andrewgho/loragate/mount/mount.3mf

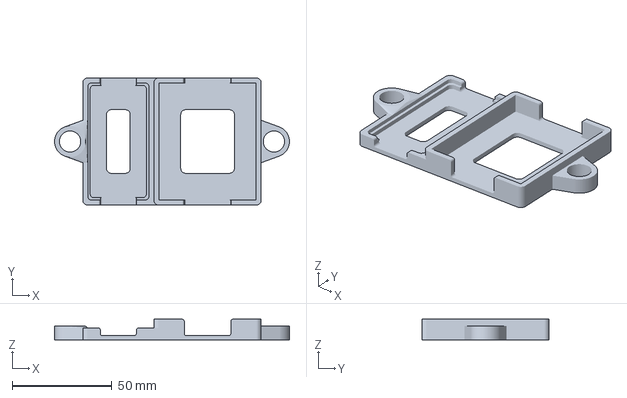
[picture p1: CAD file, 2026-10-29]
mount/mount.3mf
117.6 x 63.7 x 10.3 mm
