andrewgho/loragate/(list of files, cad)

Other CAD files:
mount/mount.stl
