andrewgho/loragate/kicad/loragate_tht/loragate_tht.kicad_pcb

## KiCad design kicad/loragate_tht/loragate_tht.kicad_pcb (2026-10-20)

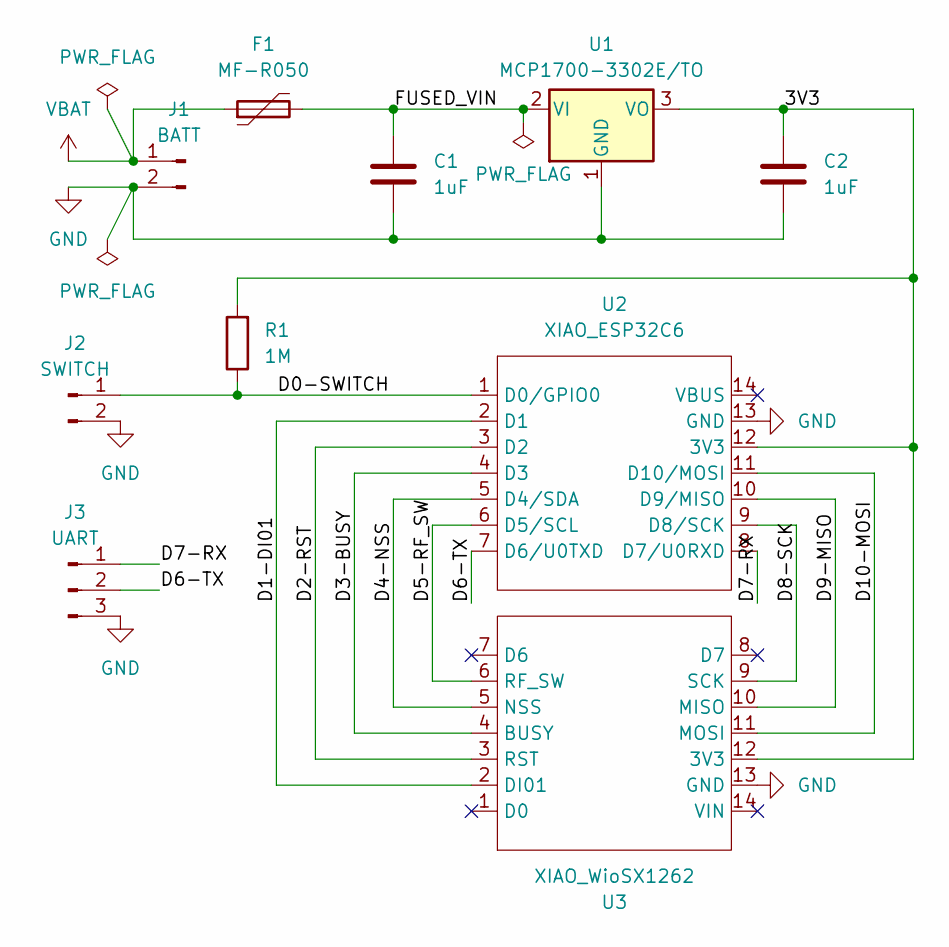
[picture p6: schematic loragate_tht.kicad_sch]

Parts:
C1, C2: 1uF; C_Disc_D5.0mm_W2.5mm_P5.00mm
F1: MF-R050; C_Disc_D8.0mm_W2.5mm_P5.00mm
J1: BATT; Molex_KK-254_AE-6410-02A_1x02_P2.54mm_Vertical
J2: SWITCH; PinHeader_1x02_P2.54mm_Vertical
J3: UART; PinHeader_1x03_P2.54mm_Vertical
R1: 1M; R_Axial_DIN0207_L6.3mm_D2.5mm_P10.16mm_Horizontal
U1: MCP1700-3302E/TO; TO-92_Inline_Wide
U2: XIAO_ESP32C6; XIAO_Module_Socket_2x7_P2.54mm_W15.24mm
U3: XIAO_WioSX1262; XIAO_Module_Pin_Flipped_2x7_P2.54mm_W15.24mm

Connections:
/3V3: C2.1, R1.2, U1.3 (VO), U2.12 (3V3), U3.12 (3V3)
/D0-SWITCH: J2.1, R1.1, U2.1 (D0/GPIO0)
/D1-DI01: U2.2 (D1), U3.2 (DI01)
/D2-RST: U2.3 (D2), U3.3 (RST)
/D3-BUSY: U2.4 (D3), U3.4 (BUSY)
/D4-NSS: U2.5 (D4/SDA), U3.5 (NSS)
/D5-RF_SW: U2.6 (D5/SCL), U3.6 (RF_SW)
/D6-TX: J3.2, U2.7 (D6/U0TXD)
/D7-RX: J3.1, U2.8 (D7/U0RXD)
/D8-SCK: U2.9 (D8/SCK), U3.9 (SCK)
/D9-MISO: U2.10 (D9/MISO), U3.10 (MISO)
/D10-MOSI: U2.11 (D10/MOSI), U3.11 (MOSI)
/FUSED_VIN: C1.1, F1.2, U1.2 (VI)
GND: C1.2, C2.2, J1.2, J2.2, J3.3, U1.1 (GND), U2.13 (GND), U3.13 (GND)
VBAT: F1.1, J1.1

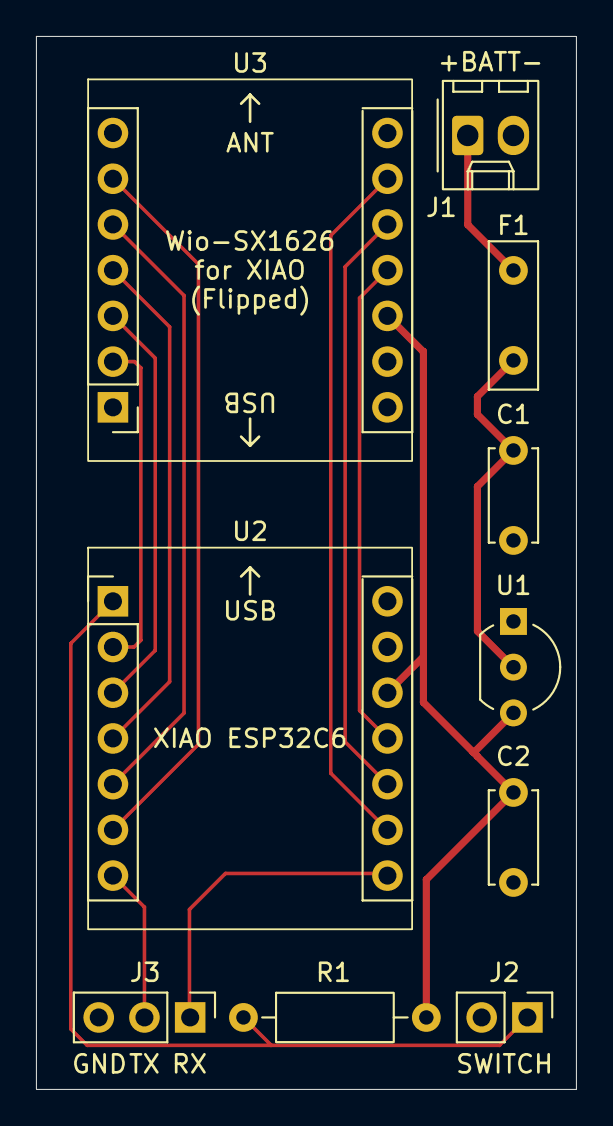
[picture p7: board loragate_tht.kicad_pcb from above]

Board: 2 copper layers, 30.0 x 58.5 mm, 10 parts (0 on the bottom side), 15 nets.
