andrewgho/loragate/(commit log)

2026-08-13 Fix pinout based on inspecting PCB manually
    [lora_pins.h]
2026-08-13 Enable DIO2 as RF switch control
    Packets weren't reaching the receiver even with pins confirmed
    correct; the SX1262 doesn't route DIO2 to the antenna switch by
    default; without radio.setDio2AsRfSwitch(true), transmit()/
    startReceive() report success but the switch never moves.
    Claude-Session: https://claude.ai/code/session_01Q1pFKiFBHSL76JCQTtfQUk
    [lora_pins.h]
2026-08-17 Add txno to packet, wire RSSI/SNR/txno into the report URL, ack-drop test knob
    txno records which transmit attempt got through (0 = first try), letting
    the server distinguish a retried link from a clean one — RSSI/SNR alone
    only describe the packet that succeeded, not whether earlier attempts on
    either leg (data out or ack back) were lost. ACK_DROP_PCT on rx-test lets
    tx-test's retry/backoff be exercised without real radio interference.
    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
    [lora_packet.h]
2026-08-27 Add transmitter build plan and wiring docs
    Physical build reference for the phase-2 transmitter (reed switch, battery,
    optional RTC), adapted from an AI-authored first draft. Corrects two things
    that draft got wrong against our actual hardware: the reed switch pin
    (D4 collides with the confirmed LoRa NSS pin) and the direct battery-to-3V3
    power architecture (3V3 is unprotected VDD; a fresh 2-cell lithium pack has
    near-zero margin against the chip's own voltage ceiling). Settled on a
    TPS7A0233 nanopower LDO + third cell, built from a bare SOT23-5 chip on a
    generic adapter board since no ready-made breakout exists at this
    quiescent-current tier.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
2026-08-27 Confirm PA0086C SOT23-5-to-DIP-6 adapter for the TPS7A02 LDO
    Checked the datasheet directly: 0.100" pin pitch, 0.300" row spacing
    (standard DIP-6/breadboard grid) and factory-installed DIP pins, so it
    drops straight into any 0.1"-grid protoboard with nothing left to solder
    but the bare LDO chip's 5 leads. DigiKey link is the preferred purchase
    source.
    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
2026-08-27 Lock in Perma-Proto Quarter and TPS7A0233PDBVR purchase links
    Settles two open build choices with DigiKey links: Adafruit Perma-Proto
    Quarter-sized board (breadboard-style bus strips, room for the LDO/adapter/
    resistor/JST-PH alongside the stack's socket without needing a second
    board) and TPS7A0233PDBVR for the LDO. Noted that the P-suffix variant is
    just a different assembly/test site per TI's own part-numbering convention,
    not a spec or pinout difference from TPS7A0233DBVR.
    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
2026-08-27 Add Keystone 2465 battery holder to the BOM
    Confirmed series wiring (4.5V, not parallel) and bare 6" leads before
    adding, since it's used directly with the JST-PH splice already planned in
    the Power section.
    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
2026-08-27 Confirm antenna chain parts, switch bypass caps to through-hole, track ownership
    Antenna chain needs two parts, not one: RF Solutions CBA-UFLSMA-1 (U.FL to
    SMA bulkhead pigtail, confirmed standard SMA not RP-SMA) and Nearson
    S463AM-915 (matching standard SMA male whip, 915MHz) - confirmed connector
    types match so the antenna actually threads onto the bulkhead. Antenna has
    no stated weatherproof rating, flagged as an open tradeoff against sourcing
    everything from one vendor.
    Capacitors switched from SMD to through-hole per no other SMD tooling in
    the build. BOM now tracks what's already on hand vs. still needed.
    Claude-Session: https:/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
2026-09-09 Add phase-2 tx/rx sketches, build/test tooling, and protocol tests
    New tx/ and rx/ sketches implement the door-sensor protocol sketched in
    README.md's "Planned protocol": heartbeat on a fixed cadence plus
    door-open/door-close events, all sharing one seq counter through the same
    send/ack/retry link layer as tx-test/rx-test. Deep sleep is left out for now
    so both ends can be watched live over serial. The reed-switch handling
    debounces the pin and, after each send/retry cycle finishes, rechecks the
    actual state and keeps resending until what's reported matches reality —
    so a transition can be reported late but the receiver is never left holding
    a stale door state.
    Also:
    - compile targets in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
    [lora_packet.h, lora_pins.h, rx.ino, tx.ino]
2026-09-29 Design battery-voltage monitoring via I2C ADC on D6/D7
    The original plan (a raw-battery divider into a spare ESP32 ADC pin, D6 or
    D7) doesn't work: the ESP32-C6's ADC1 only covers GPIO0-6, and of the three
    pins this board actually breaks out to ADC-capable headers (D0/D1/D2), D0 is
    the reed switch and D1/D2 are hard-wired to the radio module. No ADC pin is
    free at all.
    Fix: move the divider off the ESP32's ADC entirely onto a small I2C ADC on
    the D6/D7 bus, since I2C isn't pin-restricted the way ADC1 is. Settled on
    the ADS1115 after first specifying an MCP3421 and finding it forced an
    awkward firmware constraint (only 2.25M ohm input impedance against our ~6.9M
    ohm divider, requiring a forc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
2026-10-07 Document MCP1700 as a second LDO option alongside TPS7A0233
    Restructures WIRING.md's single LDO section into "Choosing an LDO" with
    two parallel options rather than replacing one with the other - the goal
    is a small library of validated power solutions for this class of
    project, not just a single answer for this transmitter.
    Option A (TPS7A0233) keeps everything already written, now flagged as not
    currently installed pending a replacement part (the first bench unit
    tested dead - 0V on OUT despite correct IN/EN voltages). Option B
    (MCP1700, TO-92) is new: confirmed working on the bench, no adapter
    needed, no EN pin to mis-wire, but with real differences worth documenting
    - a meaningfully hig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
2026-10-09 Prototype for 3D printed mount
    [mount.scad, mount.stl]
2026-10-10 Add PKT_DOOR_HELD_OPEN packet type for the left-open alert
    Phase-2 firmware needs a wire type for "door still open at the
    left-open threshold" (PLAN.md's wake behavior, not yet implemented
    in tx/rx.ino) distinct from a plain heartbeat, so the receiver can
    tell the two apart. Appended as 5 rather than inserted, since the
    existing values are live wire protocol between already-flashed
    devices.
    Claude-Session: https://claude.ai/code/session_01QEkfkKxVNizdtCCDg6THbC
2026-10-10 Wire up the transmitter's deep-sleep wake/sleep cycle
    Deep sleeps by default; wakes on any reed-switch edge and reports the
    new door state, re-reports every 300s for as long as the door stays
    open, and otherwise wakes hourly to send a heartbeat if nothing else
    has happened. RTC_DATA_ATTR carries the seq counter and committed door
    state across sleep; the rapid-slam guard re-reads the pin immediately
    before esp_deep_sleep_start() and restarts instead of sleeping through
    a last-moment edge.
    PLAN.md's original sketch assumed esp_sleep_enable_ext0_wakeup(), but
    the ESP32-C6 doesn't implement ext0 at all (no SOC_PM_SUPPORT_EXT0_WAKEUP
    in its soc_caps.h) — only ext1, which this uses instead for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
    [tx.ino]
2026-10-10 Hit a startup log endpoint on the receiver's first WiFi connect
    Lets a human watching the monitoring server's logs confirm the
    receiver came up after a reboot. Fires once, from inside
    wifi_connect() right when the connection first succeeds, so it fires
    regardless of whether that's the explicit connect in setup() or a
    later lazy reconnect triggered by an outgoing request.
    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
    [rx.ino]
2026-10-10 Sync the receiver's clock from NTP on connect and daily
    Needed so localtime= (next commit) reports something meaningful.
    Syncs from NTP_SERVER (LAN-local, default 192.168.1.1 — passed for
    all three of configTime()'s server slots so this never falls back to
    public NTP pools) on every WiFi connect, and once a day after that if
    nothing else triggers a reconnect first.
    The daily recheck needs loop() to tick on a timer instead of only
    reacting to radio packets, so this also splits the packet-handling
    body out into handle_packet() and adds a throttled run_housekeeping()
    call alongside it — the hook later commits (held-open/staleness
    thresholds, WiFi health) will hang their own periodic checks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
2026-10-10 Include localtime=<epoch seconds> on every outgoing request
    http_get() now appends this node's current time to every URL it's
    given, choosing '?' or '&' based on whether the caller's URL already
    has a query string. Lets the monitoring server compare the receiver's
    clock against its own, independent of the per-packet seq/txno already
    carried on proxied transmitter events.
    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
2026-10-10 Track door-held-open state and report it past 45s/300s
    The receiver now keeps its own idea of whether the door is open,
    independent of the transmitter's: run_housekeeping() raises
    /log/door/gate/open_past/45 once a door-open episode has run past
    SHORT_OPEN_THRESHOLD_SECONDS without a close, regardless of whether
    the transmitter has said anything else yet. Receiving the
    transmitter's own PKT_DOOR_HELD_OPEN (sent at its 300s threshold)
    raises .../open_past/300, carrying that packet's seq/txno like the
    other proxied transmitter events do.
    Also moved the ack-transmit earlier in handle_packet() (right after
    recognizing the packet type, before the per-type switch) so it covers
    PKT_DOOR_HELD_OPEN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
    [rx.ino]
2026-10-10 Alert when the transmitter's gone quiet too long
    Tracks last_rx_ms across every recognized packet (any type), starting
    the clock at setup()'s radio.startReceive() rather than waiting for
    first contact, so silence from boot onward counts too. run_housekeeping()
    raises /log/door/gate/transmission_stale?seconds=<actual elapsed> once
    that exceeds STALE_WINDOW_SECONDS (default 7260 — safely over two of
    the transmitter's default hourly heartbeat periods), and won't re-fire
    until a packet arrives and resets it.
    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
    [rx.ino]
2026-10-10 Proactively retry the receiver's WiFi connection on drop
    Until now the only reconnect path was lazy — wifi_connect() calls
    inside http_get(), triggered by an outgoing request. With no packet
    or request pending there was nothing to notice a drop. run_housekeeping()
    now checks WiFi.status() every tick and calls wifi_connect() itself
    when disconnected; that call's own WIFI_TIMEOUT_MS blocking retry
    naturally throttles how often this re-attempts during a longer outage.
    Also brings README.md's "Phase 2 protocol" section and status blurb
    up to date with everything rx/rx.ino now does — this was the last
    piece of this round of receiver work.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
2026-10-10 Make the held-open check one-shot instead of repeating
    The previous implementation re-armed HELD_OPEN_CHECK_SECONDS (300s)
    indefinitely for as long as the door stayed open, waking ~280 times a
    day for a door left open all day — real battery budget spent on a
    condition the first check already reported.
    Now tx/tx.ino sends PKT_DOOR_HELD_OPEN once per open episode (tracked
    via a new RTC_DATA_ATTR held_open_checked flag, reset on every open
    edge) and falls back to the regular HEARTBEAT_INTERVAL_SECONDS
    schedule after that check fires, door still open or not. The
    receiver's independent ~45s "door open past" alert (already in
    rx/rx.ino, unchanged here) covers "someone just opened the door" on
    i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
    [lora_packet.h, tx.ino]
2026-10-10 Reset the staleness clock on any radio reception, not just known types
    Audited the transmission-stale alert against the same "fire once,
    reset on anything received" standard just applied to the
    transmitter's held-open check. It already fired once per silence
    episode (guarded by stale_alerted), but only reset last_rx_ms/
    stale_alerted for packets that both decoded cleanly and matched one
    of the four known types — a CRC-failed or unrecognized packet left
    the clock untouched.
    Reaching handle_packet() at all means the radio's IRQ fired on our
    frequency/sync word, which is already good evidence of "heard from
    the transmitter" independent of whether the packet goes on to decode.
    Moved the reset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
    [rx.ino]
2026-10-10 Establish the door baseline even when radio.begin() fails
    Audited tx/tx.ino's wake/sleep logic against "never miss a state
    change overall" (a series of rapid transitions can collapse into
    reporting just the final state, but the net state must never
    silently drift out of sync with what's been reported). The core
    design already holds that invariant: every wake diffs the real pin
    against the persisted door_open_committed, independent of why it
    woke, with a hard backstop (HELD_OPEN_CHECK_SECONDS while open,
    HEARTBEAT_INTERVAL_SECONDS while closed) ensuring any missed edge is
    still caught within a bounded time.
    The one real gap: have_committed_state was only ever set *after*
    radio.begin() succee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
    [tx.ino]
2026-10-10 Extract tx's wake-decision logic into a pure, host-testable header
    tx/tx.ino's setup() tangled two things together: hardware I/O
    (digitalRead, radio.begin(), Serial, esp_sleep_*) and a pure decision
    ("given the fresh pin reading and the persisted state, what do we
    send, and what's the next state?"). That decision tree is exactly
    what the last two rounds of manual audit were spent verifying by
    hand — moving it into door_wake_logic.h (plain C++, no Arduino
    includes, same pattern lora_packet.h already uses for the wire
    format) makes it host-testable without any Arduino toolchain.
    Pure refactor, no behavior change: the three separate RTC_DATA_ATTR
    bools become a single RTC_DATA_ATTR DoorWakeS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
2026-10-10 Sync docs with the deep-sleep/rx-enhancement/testing work, add CLAUDE.md
    README.md: documented make compile/make test from the repo root (never
    written down before), pointed the Phase 2 protocol section at
    tx/door_wake_logic.h and its test, and corrected the toolchain section
    — arduino-cli is in fact installed on this Linux box (used throughout
    this round of work), not macOS-only as previously stated.
    PLAN.md: pointed "Wake behavior" and "Never missing a state change" at
    door_wake_logic.h and test_tx_wake_logic.cpp now that the decision
    logic lives there and is regression-tested, not just manually audited.
    Added CLAUDE.md (new — modeled on the thermometer repo's) as a
    quick-orientation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
2026-10-10 Gate the wait-for-serial-monitor loop behind -DDEBUG on tx
    Live deep-sleep testing showed 3-4s of human-noticeable latency
    between a reed-switch edge and the event being reported. Root cause:
    setup() unconditionally waited up to 3000ms for a USB host to notice
    and open a serial connection, before doing anything else — including
    before reading the door pin or touching the radio. Deep sleep powers
    down the USB peripheral, so every wake forces a fresh enumeration;
    with no monitor attached (every real deployment), !Serial never goes
    true early and the loop burns its full timeout every single time.
    Beyond the latency, this was a real battery-life bug: ~3s of
    fully-awake CPU current on every wa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
    [tx.ino]
2026-10-10 Add PKT_DIAGNOSTIC and an info byte for reset-reason reporting
    Grows LoraPacket from 6 to 7 bytes with a new `info` field, reserved/0
    for every existing type, and adds PKT_DIAGNOSTIC — the transmitter
    reporting an abnormal boot/reset reason (info = esp_reset_reason_t
    cast to uint8_t). Prep for wiring up actual detection/reporting on tx
    and logging on rx in the next two commits.
    A dedicated field rather than reusing txno: send_event()'s retry loop
    already overwrites txno with the attempt number every retry, so the
    reason would get clobbered on any retry past the first. A dedicated
    type rather than folding into PKT_HEARTBEAT: keeps "this is an anomaly
    report" explicit at the protocol level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
    [lora_packet.h]
2026-10-10 Report abnormal reset reasons via PKT_DIAGNOSTIC
    Prompted by a live-testing symptom: rapid open/close toggling
    occasionally dropped the close event and reset next_seq to 0 — only
    explainable by an actual power-on/brownout reset (RTC_DATA_ATTR is
    otherwise never zeroed), most likely from two LoRa TX current bursts
    landing close together on the battery/LDO.
    setup() now checks esp_reset_reason() right after the radio comes up,
    and sends PKT_DIAGNOSTIC carrying the raw reason code whenever it's
    anything other than ESP_RST_DEEPSLEEP (every routine wake) or
    ESP_RST_SW (our own rapid-slam-guard restarts). No new persisted
    state needed — the reason naturally reads back as one of those two
    routi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
    [tx.ino]
2026-10-10 Proxy PKT_DIAGNOSTIC to an HTTP log endpoint
    Recognizes PKT_DIAGNOSTIC in handle_packet() (acked and resets the
    staleness clock like the other four types), maps its info byte to a
    short name via reset_reason_name() (falling back to "unknown" for
    anything not in the table, with the raw numeric code still sent
    separately so an unmapped future reset reason stays visible), and
    hits DIAGNOSTIC_URL_TEMPLATE with that name plus the code and the
    usual seq/txno.
    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
    [rx.ino]
2026-10-10 Document the PKT_DIAGNOSTIC reset-reason mechanism
    PLAN.md gets a new "Reset diagnostics" section: the live-testing
    symptom that prompted it (seq resetting to 0, only explainable by an
    actual power-on/brownout reset), the mechanism (esp_reset_reason()
    needs no persisted state since it only ever reports the immediately
    preceding boot's cause), and the still-open hardware hypothesis (two
    TX current bursts landing close together on a 1µF-capped MCP1700).
    README.md's "Phase 2 protocol" and CLAUDE.md's design-decisions list
    updated to match.
    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
2026-10-10 Wait for NTP to actually land before the first outgoing request
    configTime() only starts the SNTP client — the reply arrives
    asynchronously. On first WiFi connect, sync_ntp() returned
    immediately and wifi_connect() went straight into the startup-log
    http_get(), which read time(nullptr) before any reply had landed:
    observed live as localtime=2 (just uptime, not a real epoch) on that
    one request, with every later request looking fine.
    sync_ntp() now waits up to NTP_SYNC_WAIT_MS (2s) for time(nullptr) to
    read back past a sane epoch threshold before returning. Bounded, not
    blocking forever — if the server doesn't answer in time, proceeds
    anyway, same best-effort treatment localtime already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
    [rx.ino]
2026-10-10 Detect abnormal resets before radio.begin(), not after
    Live testing found the diagnostic silently missing for a confirmed
    seq-reset-to-0 event. Root cause: esp_reset_reason() was only checked
    in setup()'s success path, after radio.begin() had already succeeded.
    But the wake immediately after an abnormal reset is exactly the one
    radio.begin() is least likely to succeed on — if it fails there, that
    wake goes straight to the failure branch's sleep-and-retry with the
    reason never even checked. The *next* wake's own reset reason then
    reads back as the routine ESP_RST_DEEPSLEEP cause for *that* wake, and
    the original anomaly is gone for good. Matches what was observed: no
    diagnostic, immediately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
    [tx.ino]
2026-10-10 Track the MCP1700/TPS7A02 datasheets referenced from PLAN.md
    Added locally to pull the real load-transient numbers for the
    brownout investigation (PLAN.md's "Reset diagnostics") rather than
    reasoning from memory. Tracking the source PDFs, not the pdftotext
    extractions used to search them — same split the thermometer repo's
    xiao-sen63c/datasheets/ already uses.
    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
2026-10-11 Log reset reason and pending-diagnostic state on every boot
    The diagnostic is still going missing for the rapid-toggle-induced
    seq reset, even with detection moved before radio.begin() — but a
    manual unplug/replug reliably reports correctly (poweron, or once,
    curiously, brownout on the first retry after a reset). Both ends of
    that gap should be caught identically by the current code, so rather
    than keep guessing which of several hypotheses explains it (a
    sequence of brownouts each wiping diagnostic_pending before a clean
    send; or something corrupting RTC memory without going through any
    reset esp_reset_reason() can observe at all, which no software check
    could ever catch), log the reset re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
    [tx.ino]
2026-10-11 Fix the real bug: RTC_DATA_ATTR doesn't survive ESP.restart()
    A live capture with full tx-side serial visibility (UART0, via an
    external USB-TTL adapter, since native USB CDC drops on every deep
    sleep) nailed this down precisely: the rapid-slam guard's
    ESP.restart() produced rst:0xc (SW_CPU) on the next boot, which
    correctly reports esp_reset_reason() == ESP_RST_SW — but
    wake_state.have_committed_state came back false anyway, and next_seq
    was back at 0. RTC_DATA_ATTR is only documented to survive deep sleep
    ("esp_attr.h": "will keep its value during a deep sleep / wake
    cycle") — restart was never covered, confirmed by a Stack Overflow
    answer the user found and then verified directly agai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
    [lora_packet.h, rtc_checksum.h, rx.ino, tx.ino]
2026-10-11 Add host-side tests for rtc_checksum.h
    Determinism, sensitivity to each of the four inputs individually, and
    one property worth pinning down explicitly rather than trusting by
    inspection: the checksum of the all-safe-reset-values input (next_seq
    0, wake_state all false, diagnostic_pending false, info 0) is
    non-zero. That matters because uninitialized SRAM commonly powers up
    as all-zero bytes — if that checksum could also be 0, a true first
    boot where persisted_checksum itself also happens to read back as 0
    would validate by coincidence instead of correctly failing. FNV-1a
    can't actually produce 0 here (odd offset basis, odd prime — odd
    times odd is never a multiple of 2^32), but a test i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
2026-10-11 Sync docs with RTC_NOINIT_ATTR persistence fix and real TX current figures
    CLAUDE.md and README.md still described the old RTC_DATA_ATTR-based
    diagnostic mechanism; update both to reflect the RTC_NOINIT_ATTR +
    FNV-1a checksum fix (bec8843, 73e26f7) and explain why RTC_DATA_ATTR
    was wrong (survives deep sleep but not ESP.restart()). Also correct
    PLAN.md's TX current figure from ~35mA to ~120-125mA, sourced from the
    Semtech SX1261/2 and Seeed Wio-SX1262 datasheets, and recompute the
    dependent battery-life estimates.
    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
2026-10-11 Fix rx double-notifying the server on an ack-loss retry
    Caught by manual review of a live field log: rx acks every recognized
    packet unconditionally (correct, needed so tx stops retrying), but was
    also re-running the full per-type handling -- including the HTTP
    notify, and for PKT_DOOR_OPEN resetting door_opened_at_ms -- on a retry
    whose only problem was a lost ack on the way back to tx, not a failed
    original send. Add rx/seq_dedup.h's is_duplicate_seq() to gate
    everything after the ack on an exact repeat of the last seq processed
    (not <=, since a lower seq means real tx-side data loss worth
    reporting, not a duplicate), with a host-side test.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
    [rx.ino, seq_dedup.h]
2026-10-11 Stop spurious reed-switch wakes from firing a heartbeat or held-open check
    Caught by manual review of a live field log: three heartbeats fired
    within ~2 seconds, nowhere near HEARTBEAT_INTERVAL_SECONDS apart. Root
    cause: decide_wake_action() had no way to tell "the RTC timer actually
    elapsed" apart from "a real ext1 edge fired but settled back to the
    same debounced state" (reed-switch contact bounce/chatter, plausible on
    an outdoor gate) -- both landed on the same heartbeat/held-open-check
    branches. Worse than wasting a radio cycle on an unneeded heartbeat,
    the same gap could consume the held-open check's one-shot budget long
    before HELD_OPEN_CHECK_SECONDS had actually passed.
    Add a timer_w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
2026-10-11 Include the hourly heartbeat floor and held-open checks in battery estimate
    The active-current line only ever counted the 20 door transitions/day
    -- it never added the hourly heartbeat floor or held-open checks that
    PLAN.md's own "Wake behavior" section describes, so even a perfectly
    quiet day's heartbeat traffic was going entirely unmodeled. Recompute
    using a conservative ~54 events/day (20 transitions + up to 24
    heartbeats + up to 10 held-open checks), which moves both LDO options'
    estimates down by roughly half a year to a year. Conclusion is
    unchanged -- still comfortably clears the "2+ years" bar -- but the
    numbers themselves were off. Also note send_event()'s retries aren't
    modeled, fo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
2026-10-11 Add a resettable PTC fuse between the battery holder and the LDO
    The MCP1700 and the L91 cells each already protect themselves (the
    LDO's own internal overcurrent/thermal shutdown on the output side,
    each cell's internal PTC + pressure-relief vent on the input side,
    independently rated to survive a direct short per UL 1642/IEC 62133-
    style cell safety testing) -- but nothing protects the wiring, JST-PH
    connector, or battery holder contacts between them, which carry no
    comparable rating against the multi-second, several-amp transient a
    raw-pack short can still drive through them.
    Add Bourns MF-R050 (TE/Raychem RXE050 as a dual-sourced equivalent) in
    series on the battery side. Sized to the M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
2026-10-11 Stop a corrupted/unrecognized reception from suppressing repeat staleness alerts
    Caught live: rx logged five readData() CRC-mismatch failures (-7) right
    after a transmission-staleness alert, while tx was confirmed powered
    off overnight. handle_packet() cleared the one-shot alert latch
    (stale_alerted) unconditionally on any radio IRQ, on the theory that
    reaching the function at all meant the IRQ matched our sync word and
    so counted as "heard from tx" -- but a CRC-failed reception carries no
    reliable evidence it actually came from our own transmitter rather
    than ambient RF noise/interference. Left as-is, a noise event landing
    after a real outage would silently re-arm-and-then-reset the latch,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
    [rx.ino]
2026-10-13 Remove NTP sync and localtime= reporting from rx
    Only use was a human glancing at server logs, and that was never
    reliable: sync_ntp() could still lose the race against the very first
    startup-log request, reporting a bogus small epoch instead of a real
    one. Fixing that bug properly would have meant threading a "do we know
    the time yet" check into http_get() -- but the original motivation for
    having rx's clock at all was a stepping stone toward reconstructing
    actual door-event timing, and that's not being pursued: the gap is
    usually 0-1s at the radio level and gets swamped by the notification
    channel's own latency regardless, so the whole mechanism (sync_ntp(),
    the daily resync, NTP_SERVER, t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
    [rx.ino]
2026-10-13 Default tx production builds to UART0 Serial, keep USB CDC for debug
    Native USB CDC doesn't survive deep sleep and nobody's plugged into it
    in the field anyway; UART0 (via an external FTDI adapter) does survive
    it and is what made the brownout/RTC_NOINIT_ATTR investigation possible
    earlier this session -- but that required a one-off reflash with a
    non-default CDCOnBoot setting. Make it the standing default for
    production builds instead, so any future field investigation works on
    whatever's already flashed. Debug builds keep CDCOnBoot=cdc (one USB
    cable for both flashing and monitoring when someone's actually there).
    Confirmed no pin conflict: UART0's D6/D7 are listed as unused
    passthroughs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
2026-10-18 EXPERIMENTAL: hold NSS across deep sleep, isolated test
    Live PPK2 measurement found idle/sleep current at ~1.5mA, ~40x the
    ~40uA predicted worst case. Leading hypothesis: the SX1262 treats a
    falling edge on NSS as a wake-from-SLEEP trigger (datasheet section
    8.2.2), and ESP32-C6 does not retain a GPIO's driven level across deep
    sleep unless held -- so NSS resets/floats right as we enter sleep,
    which looks exactly like that falling edge and pulls the radio back
    into STDBY (0.6-0.8mA typ per the datasheet) for the whole sleep
    duration, not just a glitch. That's consistent with both the magnitude
    and the fact that it measures as a stable, non-noisy 1.5mA rather than
    something transient.
    This h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
    [tx.ino]
2026-10-18 EXPERIMENTAL: also hold RFSW across deep sleep
    NSS alone (previous commit) confirmed real: live PPK2 measurement
    dropped from ~1.5mA to ~318uA, consistent with the SX1262
    wake-from-SLEEP-on-NSS-falling-edge theory. Still well above the
    ~41-44uA budgeted target, though, so something else is also elevated.
    LORA_RFSW is the next-most-likely candidate: same root cause (ESP32-C6
    doesn't retain a GPIO's driven level across deep sleep unless held),
    different pin -- and unlike the other unretained SPI lines
    (SCK/MOSI/MISO), which a deselected SPI slave should mostly ignore once
    NSS is correctly held, RFSW plausibly gates something closer to an
    analog bias or switch-driver circuit on the Wio-SX1262 m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
    [tx.ino]
2026-10-18 EXPERIMENTAL: drive RFSW LOW (not HIGH) before holding it across sleep
    Holding RFSW HIGH through sleep (previous commit) regressed slightly,
    ~318uA to ~368uA -- actively keeping the RF switch circuit enabled
    through sleep costs real current, more than whatever undefined state
    it floats to on its own. HIGH is the documented "awake, radio in use"
    level, so in hindsight that's not a surprising place for extra current
    to show up. LOW is the only other defined level for this pin and has
    never actually been driven/tested; this tries explicitly driving it
    LOW before holding it there, to see whether that's the switch's
    genuine disable/low-power state rather than just reverting to
    floating.
    Not yet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
    [tx.ino]
2026-10-18 EXPERIMENTAL: explicitly disable internal pulls on REED_PIN
    Live PPK2 data pinned the remaining ~297uA sleep-current gap (after
    the NSS/RFSW fixes) precisely to door state: ~318uA closed, ~21uA
    open (matching the budgeted target). Pull-up resistor itself confirmed
    correctly 1M via its color bands, ruling out the external circuit.
    Leading theory: REED_PIN is one of the C6's 8 RTC-capable GPIOs
    (required for ext1 wakeup), with its own RTC/LP-IO-domain pull-up/
    pulldown enable bits separate from the regular digital-GPIO pull config
    pinMode(INPUT) controls. A redundant internal pull left enabled would
    be invisible while the switch is open (no completed circuit either
    way) but would draw real cu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
    [tx.ino]
2026-10-18 DIAGNOSTIC-ONLY: disable ext1 wakeup to isolate the 750us current spikes
    Does NOT wake on a real door event in this build -- timer wakeup only.
    Bench/PPK2 measurement only; must be reverted before flashing anything
    meant to actually run in the field.
    Zoomed-in PPK2 data showed the ~318uA sleep current with the door
    closed isn't flat -- it's a ~30uA floor (at/better than the ~41-44uA
    budget) with periodic ~1.5mA spikes every ~750us. The open-door state
    (no low-impedance short on REED_PIN) shows no such spikes, just a
    small zigzag around 18.5-21uA. The internal-pull-disable fix from the
    previous commit made no difference, ruling out a continuously-enabled
    pull resistor as the cause.
    Leading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
    [tx.ino]
2026-10-18 DIAGNOSTIC: print the active RTC slow clock source
    Disabling ext1 entirely in the previous commit made no difference --
    the 318uA/1.5mA-spikes-every-750us signature persists purely based on
    the reed switch's physical open/closed state, with ext1 not even
    armed. That rules out ext1-specific wakeup logic as the cause.
    New candidate: GPIO0/REED_PIN is also multiplexed as XTAL_32K_P, one of
    the two pins for an *external* 32.768kHz crystal input to the RTC slow
    clock -- this board has no such crystal anywhere. Repeatedly attempting
    to start up a crystal that isn't physically present is a documented
    general ESP32 current-draw pitfall, and the attempt's electrical
    behavior plausibly depends on whe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
2026-10-18 Revert to NSS-only baseline (the one with a confirmed positive result)
    Undoes everything after ae1d336: holding RFSW (proven neutral/slightly
    negative in both HIGH and LOW variants), disabling REED_PIN's internal
    pulls (no measurable effect), and the two diagnostic-only builds
    (disabling ext1 entirely, printing the RTC slow clock source). All
    four were genuine, useful negative results -- they ruled out real
    candidates -- but none improved on NSS alone, so there's no reason to
    carry the extra code forward. Clean base to continue from: NSS held
    across deep sleep (~318uA with the door closed, ~20uA open -- the
    sleep-current investigation continues from here, not from any of the
    reverted experim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
    [tx.ino]
2026-10-18 DIAGNOSTIC-ONLY: skip radio.begin()/SPI.begin() entirely, board stays plugged in
    Unplugging the Wio board entirely (previous session) produced clean
    ~20uA sleep current with no 750us spikes and no open/closed asymmetry
    -- a complete reversal from the ~318uA/spiky signature seen with the
    board present and radio.begin() succeeding. That leaves two
    explanations open: the board's mere electrical presence could be
    enough on its own, or something that only happens once radio.begin()
    succeeds and the radio actually gets configured/used
    (setDio2AsRfSwitch(), a real transmit) could be the real trigger --
    mere unplugging doesn't distinguish between them, since both the
    board's presence AND the whole r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
    [tx.ino]
2026-10-18 DIAGNOSTIC-ONLY: also skip radio.sleep(), making the isolation genuinely clean
    Previous commit skipped radio.begin()/SPI.begin() but left radio.sleep()
    running -- it still sends a real SPI command assuming SPI is already
    configured, so with SPI.begin() never called, that command went out as
    garbled signaling onto GPIO pins reaching a chip that's genuinely
    powered and listening. Measured result was ~2.4-3.0mA oscillating
    smoothly at ~17ms -- close to the SX1262 datasheet's Synthesizer/FS
    mode figure (~2.1mA, DC-DC), consistent with a corrupted SetSleep
    landing on a real chip and kicking it into an unintended state rather
    than actually sleeping. Self-inflicted artifact of the test being
    intern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
    [tx.ino]
2026-10-18 Revert to NSS-only baseline again, after the radio-isolation detour
    The Wio-unplug and radio-begin/sleep-skip tests (previous two commits)
    answered a different question than intended: they showed a powered-
    but-never-commanded SX1262 draws ~2.7mA regardless of door state, not
    that the board's mere presence explains the original ~318uA(closed)/
    ~20uA(open) asymmetry. That asymmetry only ever appears once
    radio.begin() and radio.sleep() both genuinely succeed -- a materially
    different regime from "radio never touched at all." So this detour
    answered a real, separate question (what happens if radio.begin() ever
    fails in the field -- see PLAN.md's Open Items) without resolving the
    one we're actu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
    [tx.ino]
2026-10-19 Document sleep-current root cause: Wio HAT button shares D0 with reed switch
    Live PPK2 measurement traced the ~1.5mA/318uA elevated deep-sleep draw
    to the Wio-SX1262 HAT's own onboard button and its 10k pull-up sharing
    the D0 net with the reed switch, confirmed against Seeed's KiCad
    schematic and a hand-wired jumper A/B test (21.9uA closed / 18.5uA open
    after bypassing D0 around the HAT). PLAN.md gets the full elimination
    writeup and updated power budget/battery-life figures; WIRING.md gets
    the physical bypass fix (snip both D0 stacking pins, bridge with a
    wire) for the as-built header-stacked construction.
    Claude-Session: https://clau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
2026-10-19 Remove phase-1 scaffolding now that tx/rx have superseded it
    PLAN.md, rx-test/, and tx-test/ were the original fixed-timer proof of
    concept and its design doc; tx/ and rx/ have long since replaced them
    with the real deep-sleep door-event protocol, so there's nothing left
    that still needs the phase-1 copies around. Repo-root Makefile and
    test/Makefile updated to match (flash-tx/flash-rx now point at tx/rx;
    the phase-1 packet-format test and its tx-test/rx-test diff check are
    gone; the remaining packet test is renamed since there's no longer a
    second phase to distinguish it from).
    Claude-Session: https://claude.ai/code/session_01QEkfkKxV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
    [lora_packet.h, lora_pins.h]
2026-10-19 Rewrite README.md and WIRING.md for a newcomer, drop PLAN.md's content
    README.md now follows one structure throughout: what the project needs
    to do, why each hardware/software choice satisfies that (power budget
    included), what the pieces are and how they fit, how the software
    works and how to build/test/flash it — with a brief History subsection
    per section pointing at the real investigations (now mostly living in
    commit messages) instead of reproducing them inline.
    WIRING.md stays a build/order reference: pin tables, the MCP1700 as
    the installed LDO (TPS7A0233 demoted to a documented alternative), the
    D0/Wio-HAT bypass fix kept but trimmed to the actionable steps, the
    ADC/DS3231 additio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
2026-10-19 Scrub code comments down to brief, non-obvious why
    Most comments in tx/ and rx/ had grown into full investigation
    narratives (the live-testing story behind a fix, not just the fix's
    own rationale) now that PLAN.md is gone and README.md carries that
    history instead. Trimmed each comment to the non-obvious reasoning a
    reader actually needs at that line, pointing at README.md's History
    subsections or the relevant header file for anything longer — no
    behavior changes, compiles clean and all host-side tests still pass.
    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
    [door_wake_logic.h, lora_packet.h, lora_pins.h, rtc_checksum.h, rx.ino, seq_dedup.h, tx.ino]
2026-10-19 Apply trivial code-review fixes: style, consistency, stale doc refs
    - tx.ino: factor the HIGH-means-open polarity check into reed_is_open(),
    used by both the rapid-slam-guard recheck and read_debounced_state()
    instead of repeating digitalRead(REED_PIN) == HIGH three times.
    - tx.ino: use DoorWakeState{...} brace-init instead of a C-style
    compound-literal cast.
    - rx.ino: spell out all 4 LoraPacket fields in the ack literal, and
    bump one stray 160-byte URL buffer up to the 256 used everywhere else.
    - rtc_checksum.h: note that hashing wake_state's raw bytes relies on it
    having no padding today.
    - test_tx_wake_logic.cpp / test_seq_dedup.cpp: fix header comments still
    pointing at the d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
    [rtc_checksum.h, rx.ino, tx.ino]
2026-10-20 Add KiCad artifacts from prototype PCB design
    [loragate_tht-B_Cu.gbl, loragate_tht-B_Mask.gbs, loragate_tht-B_Silkscreen.gbo, loragate_tht-Edge_Cuts.gm1, loragate_tht-F_Cu.gtl, loragate_tht-F_Mask.gts, loragate_tht-F_Silkscreen.gto, loragate_tht-NPTH.drl]
2026-10-28 Revamp for PCB instead of protoboard; add slicer artifacts
    [mount.3mf, mount.scad, mount.stl]
2026-10-29 Add mounting ears for outdoor rated enclosure
    I obtained a "Zulkit" brand IP65-rated ABS electrical box with hinged shell,
    marked as 5.9" x 3.9" x 2.8" external, 130mm x 81mm x 47mm internal, with
    two internal bolt mount posts supposedly with a 100mm internal distance:
    https://www.amazon.com/dp/B08KY7VK8W
    Add ears that wrap around the mount posts for the usual snap-fit (and we
    could add a bolt and washer for a more secure fit if needed).
    [mount.3mf, mount.scad, mount.stl]
2026-10-29 Adjust dimensions based on empirical fit
    * PCB was a little tight and flexed the bottom plane, so widen slightly
    * Battery holder (previously tight) got looser, so re-tighten up just a tad
    * For sturdiness, raise up battery holder wall and thicken bottom plate
    * Adjust mounting post dimensions based on observation (reported values = lies)
    This version fits cleanly in the box! Mounting post diameter could now be
    tightened down just a little bit for a tighter fit.
    [mount.3mf, mount.scad, mount.stl]
2026-10-30 rx: retry radio.begin() at boot instead of halting forever
    rx is the always-on, unattended half of the system; a transient
    SPI/radio glitch at boot previously left it permanently dead until
    someone physically power-cycled it. Retries every RADIO_BEGIN_RETRY_MS
    instead, matching tx's own degrade-and-retry philosophy for the same
    failure.
    Also reports the condition directly to the monitoring server — rx has
    WiFi, unlike tx, so it doesn't need a wire-protocol packet to tell on
    itself: ERROR_URL_TEMPLATE once on the first failure (before the first
    retry), RECOVERY_URL_TEMPLATE once if/when it later succeeds. Nothing
    extra happens on the immediate-success path beyond the usual
    STARTUP_LOG_URL.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
    [rx.ino]
2026-10-30 rx: recover from a radio failure after boot, not just at boot
    Previously only radio.begin() at boot retried on failure — once
    setup() succeeded once, a later startReceive() failure (in setup()'s
    own initial call, or either of the two inside handle_packet()) left rx
    permanently deaf with no recovery and no report, since the only
    backstop was the staleness alert up to ~2h later, which doesn't retry
    anything itself.
    ensure_receiving() replaces all three raw startReceive() call sites: a
    single-attempt wrapper that tracks radio_listening and reports
    ERROR_URL_TEMPLATE/RECOVERY_URL_TEMPLATE only on a state transition.
    Since no IRQ fires once the radio's stopped listening, recovery has to
    be dri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
    [rx.ino]
2026-10-30 rx: retry http_get() a few times on a likely-transient failure
    Previously any HTTP failure — a DNS hiccup, the server momentarily
    restarting — silently and permanently dropped that one event, no
    retry at all, unlike the LoRa leg's full ack/retry/backoff. http_get()
    now retries up to HTTP_GET_RETRIES times (short fixed delay between
    attempts) when the response looks transient: a negative code
    (HTTPClient's own connection-level failure) or 5xx (the server itself
    erroring). A 4xx isn't retried — that means the request itself is
    wrong, which retrying can't fix.
    Deliberately not a persistent retry queue: sizing it, deciding a drop
    policy once it's full, and the dequeue bookkeeping in
    run_h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
    [rx.ino]
2026-10-30 Add a draft wiring doc for the rx held-open beacon addition
    Not bench-tested or built yet — kept separate from WIRING.md (which is
    tx-only today) so it can be updated freely as the design is confirmed
    against the real beacon hardware, then merged/retired once finalized.
    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
2026-10-30 Draft beacon doc: show the flyback diode in the diagram, deprioritize it
    Diode was already in the BOM/prose but missing from the ASCII circuit
    diagram — added in parallel with the beacon. Also downgraded from
    "include regardless" to optional/skippable: at ~1cm tall and diameter,
    the actual unit is almost certainly too small for a motor (more likely
    a ring of sequenced LEDs faking the rotation), so flyback protection
    probably isn't load-bearing — left in as cheap insurance rather than
    removed outright since it hasn't been powered up to fully confirm yet.
    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
2026-10-30 Draft beacon doc: drop the flyback diode, confirmed unnecessary by PPK2
    Measured the actual unit: ~20mA average, ~25mA peak, no inrush spike
    at turn-on (a 250ms ~7mA trough instead, consistent with driver-IC
    power-on sequencing, not a motor spinning up), and a clean stepped
    waveform matching a strobed LED ring. No inductive load, no diode
    needed — removed from the circuit diagram and BOM rather than kept as
    "optional," and added a "Confirmed on the bench" section recording the
    measurement for anyone wondering later why there's no flyback diode.
    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
2026-10-30 Draft beacon doc: confirm signal-wire-floating default, sketch mode-select
    Confirmed on the bench: leaving the beacon's signal wire disconnected
    gives the default rotating pattern, so the core design needs no
    connection to it at all (checklist updated accordingly, and the
    Circuit section's now-stale "confirm first" pointer fixed).
    Also sketched the optional software mode-select path for later, since
    it's easy and the user was curious: D7/GPIO17, a 50Hz/1-2ms RC-servo-
    style PWM signal via the LEDC peripheral (ledcAttach/ledcWrite — the
    current Arduino-ESP32 core 3.x API), with a suggested empirical sweep
    to map pulse width to mode since there's no published spec for this
    unit. Not wired u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
2026-10-30 Draft beacon doc: finalize connector choice, design now fully confirmed
    Factory harness confirmed as a standard 1x3 2.54mm DuPont-style female
    header — matching male header on the rx side, no adapter needed. Added
    an explicit warning that the header's "GND" position is actually the
    MOSFET drain (the switched node), not the board's GND rail, since
    wiring it straight to GND would bypass the switch and leave the beacon
    permanently on; also noted DuPont pin order isn't standardized, so wire
    to match whatever was confirmed working on the bench, not an assumed
    position.
    Every item in the bench-test checklist is now checked off — updated the
    top banner to reflect that the design itself is sett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
2026-10-30 rx: drive the held-open beacon GPIO, on for now whenever the door's open
    Testing-phase behavior per RX_BEACON_WIRING.md's design: D6/GPIO16
    switches the beacon's low-side MOSFET on for the entire time
    door_is_open is true, off otherwise.
    Structured so swapping to the intended later behavior (lit only once
    the 45s short-open or 300s tx-confirmed held-open warning has actually
    fired, not immediately on open) is a one-line change to
    beacon_should_be_on() with no call-site hunting: every mutation of
    door_is_open (both PKT_DOOR_OPEN/CLOSE/HELD_OPEN in handle_packet(),
    for immediate responsiveness) calls update_beacon(), and
    run_housekeeping() also calls it unconditionally once per tick as a
    back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
    [rx.ino]
2026-10-31 rx: move beacon switch from D6 to D0 — D6 is UART0, not actually free
    Bench-confirmed D6/GPIO16 doesn't work for this: gate measured a
    constant ~3V regardless of door state or anything the firmware wrote
    to the pin. Root cause, confirmed against Arduino-ESP32/Espressif docs:
    GPIO16/17 are the ESP32-C6's UART0 TX/RX pins, fixed at the hardware
    level (not GPIO-matrix-reroutable like most peripherals), and the
    core's USB-CDC build still routes debug/console output through UART0
    independent of CDCOnBoot — so something below the application level
    had its own claim on the pin the whole time. D7 is equally suspect for
    the same reason, so it's no longer assumed safe for the optional
    mode-select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
    [rx.ino]
2026-10-31 Confirm D0 beacon switch works; correct the UART0 claim with hard evidence
    D0 confirmed working on the bench. Doc and checklist updated throughout
    to reflect that — design, firmware, and pin choice are all now settled.
    Corrected the record on two points:
    1. The "D0 never turns on, gate reads ~1.6V" symptom seen right after
    moving the wire was NOT a hardware fault, despite looking like one
    (the reading matches passive resistor-divider math for an undriven
    pin almost exactly). Root cause was a stale checkout on the macOS
    flashing box — it hadn't pulled the D6->D0 commit, so it kept
    flashing firmware that only ever touched D6, leaving D0 genuinely
    undriven. No wiring was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
    [rx.ino]
2026-11-01 Record beacon protoboard layout and current build status for handoff
    RX_BEACON_WIRING.md: captured the actual protoboard layout work (board
    topology, final hole assignments, the GND/D0 hole-mixup bug caught and
    fixed before anything was soldered, the MOSFET-orientation verification
    and why it still needs a physical dry-fit) — this only existed in
    conversation until now. Updated the banner and checklist to reflect
    "designed and reviewed, not yet soldered" rather than implying this is
    closer to done than it is. Noted in Firmware status that
    beacon_should_be_on() is still deliberately in its testing-phase
    behavior (lit for the whole open duration), not yet switched to the
    45s/300s-gated versi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
2026-11-04 rx: set DHCP hostname and advertise mDNS on WiFi connect
    So the receiver shows up by name in the UniFi console (which also
    serves local DNS for DHCP client names) and resolves as
    <name>.local. RX_HOSTNAME is a new required local.h value, default
    "gate-sensor-rx" in local.h.example — existing local.h copies need it
    added.
    WiFi.setHostname() has to come before WiFi.begin(): in the installed
    core (3.3.11) it's only applied to the STA netif when STA mode first
    starts. MDNS.begin() runs once, on the first successful connect; the
    responder follows the netif through later reconnects on its own.
    Claude-Session: https://claude.ai/code/sessio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
    [rx.ino]
2026-11-04 rx: condense comments and beacon doc to what/why; history to History
    Comments in rx.ino and seq_dedup.h had accumulated history and
    step-by-step reasoning; cut each to a short "what and why", leaving
    the history to the docs (README's Software history already carries the
    rx entries, e.g. the stale-alert latch).
    RX_BEACON_WIRING.md had history woven through every section. Body now
    describes current design only; a new History section at the end holds
    the D6 attempt, the stale-checkout detour, the B3/C2 layout bug, the
    dropped flyback diode, and the original D7 mode-select suggestion. No
    facts or warnings dropped.
    - lora_pins.h (both copies, kept identical): setDio2AsRfSwitch is no
    lon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
    [lora_pins.h, rx.ino, seq_dedup.h]
2026-11-04 docs: merge rx beacon doc into WIRING.md; parallel tx/rx sections
    WIRING.md is now "Wiring" with three sections: "Shared radio stack"
    (radio pin table, plus the catch on each leftover header pin — D0
    shares the HAT's button/pull-up net, D6/D7 are UART0 claimed by the
    ESP-IDF console), "Transmitter" (existing content, headings demoted,
    plus a note that it describes the protoboard build, not the KiCad
    PCB), and "Receiver" (pin table, mounting, held-open beacon, power,
    future additions, BOM — same shape as tx's). RX_BEACON_WIRING.md is
    deleted.
    README's Hardware section gets matching Transmitter/Receiver
    subsections; Software → Receiver gains a beacon bullet; the beacon's
    history (D6 att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
2026-11-04 docs: document tx PCB and rx protoboard as built, with photos
    tx (WIRING.md Transmitter): the custom PCB is now the documented
    current build, the Perma-Proto build kept alongside as the original.
    The PCB seats the XIAO and Wio-SX1262 side by side instead of as a
    HAT, with the Wio flipped on its back for easier routing; leaving the
    Wio's D0/D6/D7/VIN unconnected isolates the reed switch from the HAT's
    button without modifying either module. D6/D7 go to a J3 UART header
    for FTDI monitoring (the I2C future-additions caveat now says so).
    Battery disconnect is Molex KK-254-style (generic KF2510 kit) —
    JST-PH abandoned, its crimp pins aren't practical to crimp at home.
    Enclosure is IP65 hinged-l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
